nruizneiman/IRis/docs/firmware/dependencies.md

# Dependencies

## Versions the project is built with

| Item | Version | Where | Evidence |
|---|---|---|---|
| PlatformIO Core | 6.2.0 | `.venv` | `pio --version` |
| Platform `espressif32` | 6.12.0 (pinned) | `platformio.ini` | firmware built |
| Arduino-ESP32 core | 2.0.17 | installed `framework-arduinoespressif32` reports `3.20017.241212` | package.json (PlatformIO encodes 2.0.17 as 3.20017.x) |
| Xtensa GCC | 8.4.0 (2021r2-patch5) | PlatformIO package | package.json |
| ArduinoJson | 7.4.2 (pinned in `lib_deps` and vendored for the host build) | firmware + `third_party/` | firmware built; host tests pass |
| U8g2 | 2.36.18 (pinned in `lib_deps`) | firmware | all firmware environments build. In use on an SSD1306 panel; the SH1106 class compiles but was never tried on such a panel |
| IRremoteESP8266 | 2.9.0 (pinned in `lib_deps`) | firmware + PC cross-check | API read from the installed sources; all environments build; the PC cross-check passes ([IR layer](ir.md)). In use on the device, where only NEC remotes were confirmed |
| LittleFS | part of Arduino-ESP32 2.0.17 | firmware | in use on the device; its behaviour under a power cut was not provoked there |
| doctest | 2.4.11 (vendored) | `third_party/doctest` | host tests pass |
| Host compiler | GCC 16.2.0 (WinLibs MinGW-w64 UCRT) | winget | `g++ --version` |

## Not verified

| Item | State |
|---|---|
| IRremoteESP8266 with core 3.x | Unknown; the project stays on core 2.0.17 |
| U8g2 font `u8g2_font_5x8_tf` | The menus read well on the panel; that it renders every Spanish glyph used (n-tilde, accents, inverted ! ?) was not checked one by one |
| Wokwi | Its documentation lists the SSD1306 and a 38 kHz IR receiver, and no SH1106. The project in `wokwi/` was never opened |
| Library sources on the PC | `test/hostlib` reads them from `.pio/libdeps/esp32dev/IRremoteESP8266` (created by `pio run`); not vendored because of the LGPL licence and size |

## Flipper-IRDB (data, not linked code)

- Source: https://github.com/Lucaslhm/Flipper-IRDB. Licence: **CC0 1.0 Universal** (LICENSE file and README read 2026-11-01).
  The README download links point at a different owner (logickworkshop/Flipper-IRDB); whether that is a move or a fork reference is unconfirmed.
- Used as: `.ir` text files copied to the SD card and converted by `lib/iris_core/src/import/FlipperIr.*`. Nothing from the
  repository is bundled in the firmware. One real file is kept as a test fixture (`test/fixtures/irdb_LG.ir`, see `irdb_README.txt`).
- Field meaning for NEC / NECext / Samsung32 / SIRC was confirmed by reading Flipper's encoders (flipperzero-firmware, lib/infrared/encoder_decoder). Other protocols are skipped and counted, not guessed.
