nruizneiman/IRis/case/IRis Mando v2 v24.png

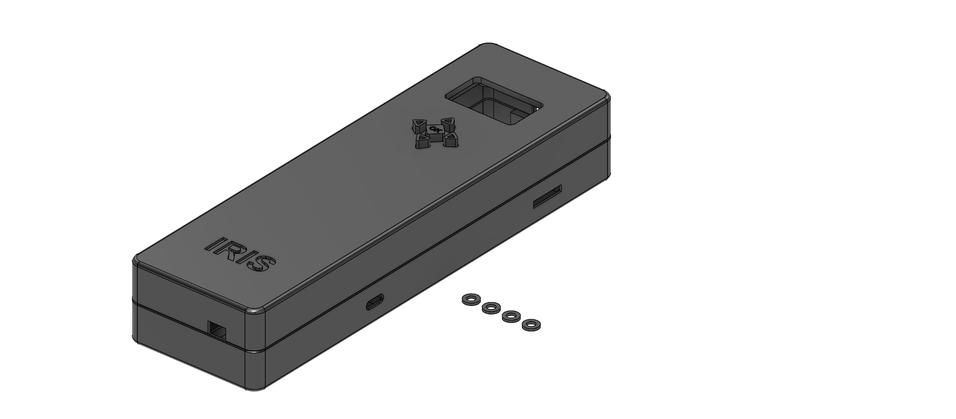
case/IRis Mando v2 v24.png
