nruizneiman/IRis/docs/img/social-preview.png

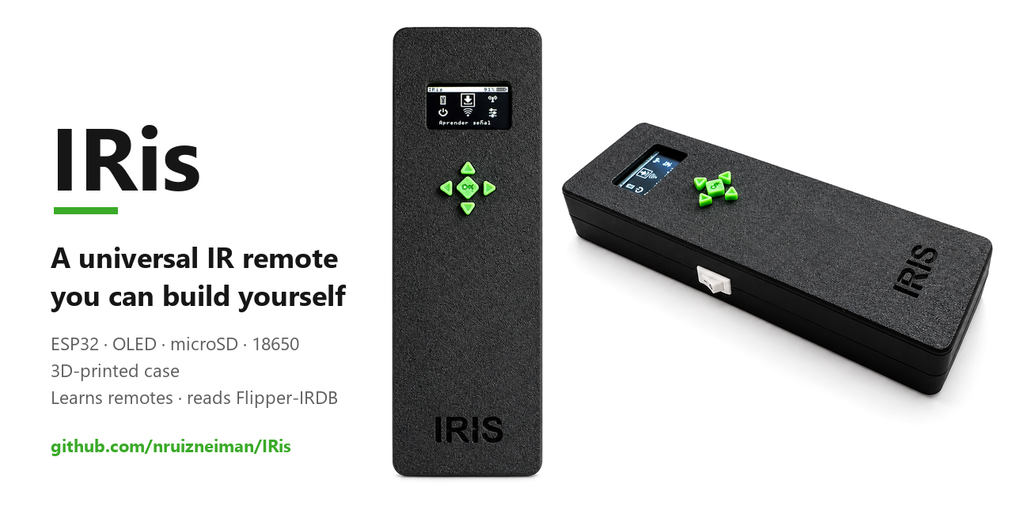
docs/img/social-preview.png
