nruizneiman/IRis/case/IRis Mando v2.step

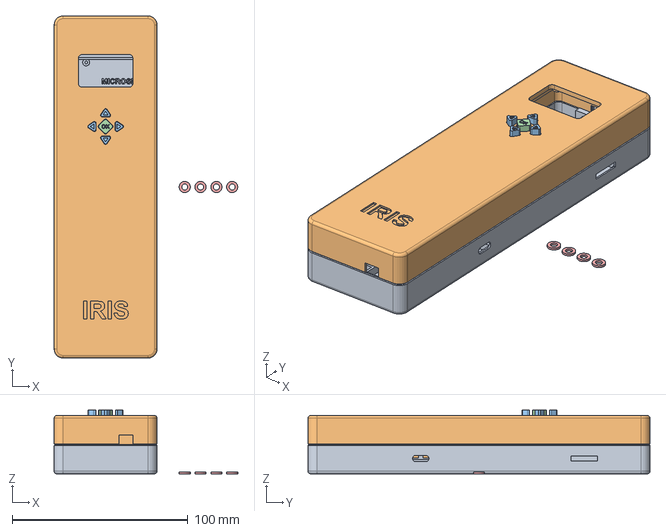
[picture p5: CAD file, 2026-11-11]
case/IRis Mando v2.step
104.5 x 194.5 x 36.2 mm
