nruizneiman/IRis/case/IRIS_Case.3mf

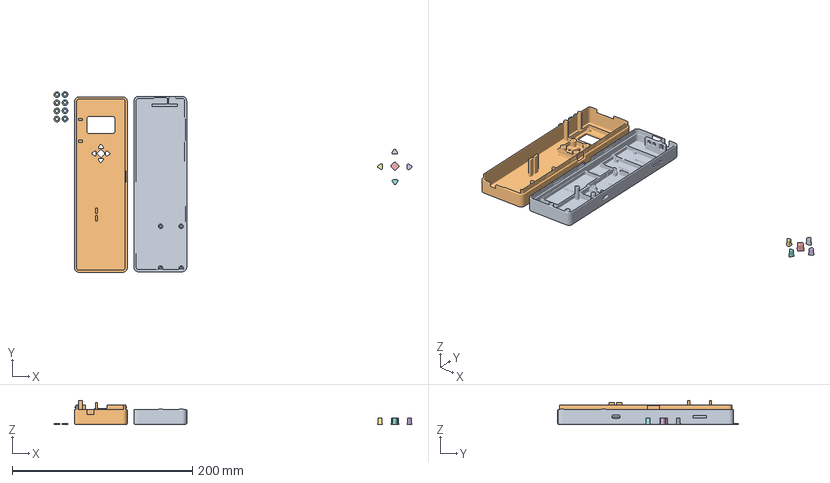
[picture p6: CAD file, 2026-11-11]
case/IRIS_Case.3mf
396.8 x 200.3 x 26.7 mm
base.stl
tapa.stl
arandelas_oled_x4.stl x 2
tecla_ok.stl
tecla_derecha.stl
tecla_izquierda.stl
tecla_abajo.stl
tecla_arriba.stl
