nruizneiman/IRis/(list of files, cad)

Other CAD files:
case/IRis Mando v2.f3d
