nruizneiman/IRis/docs/schematic/IRis.kicad_sch

## KiCad design docs/schematic/IRis.kicad_sch (2026-11-11)

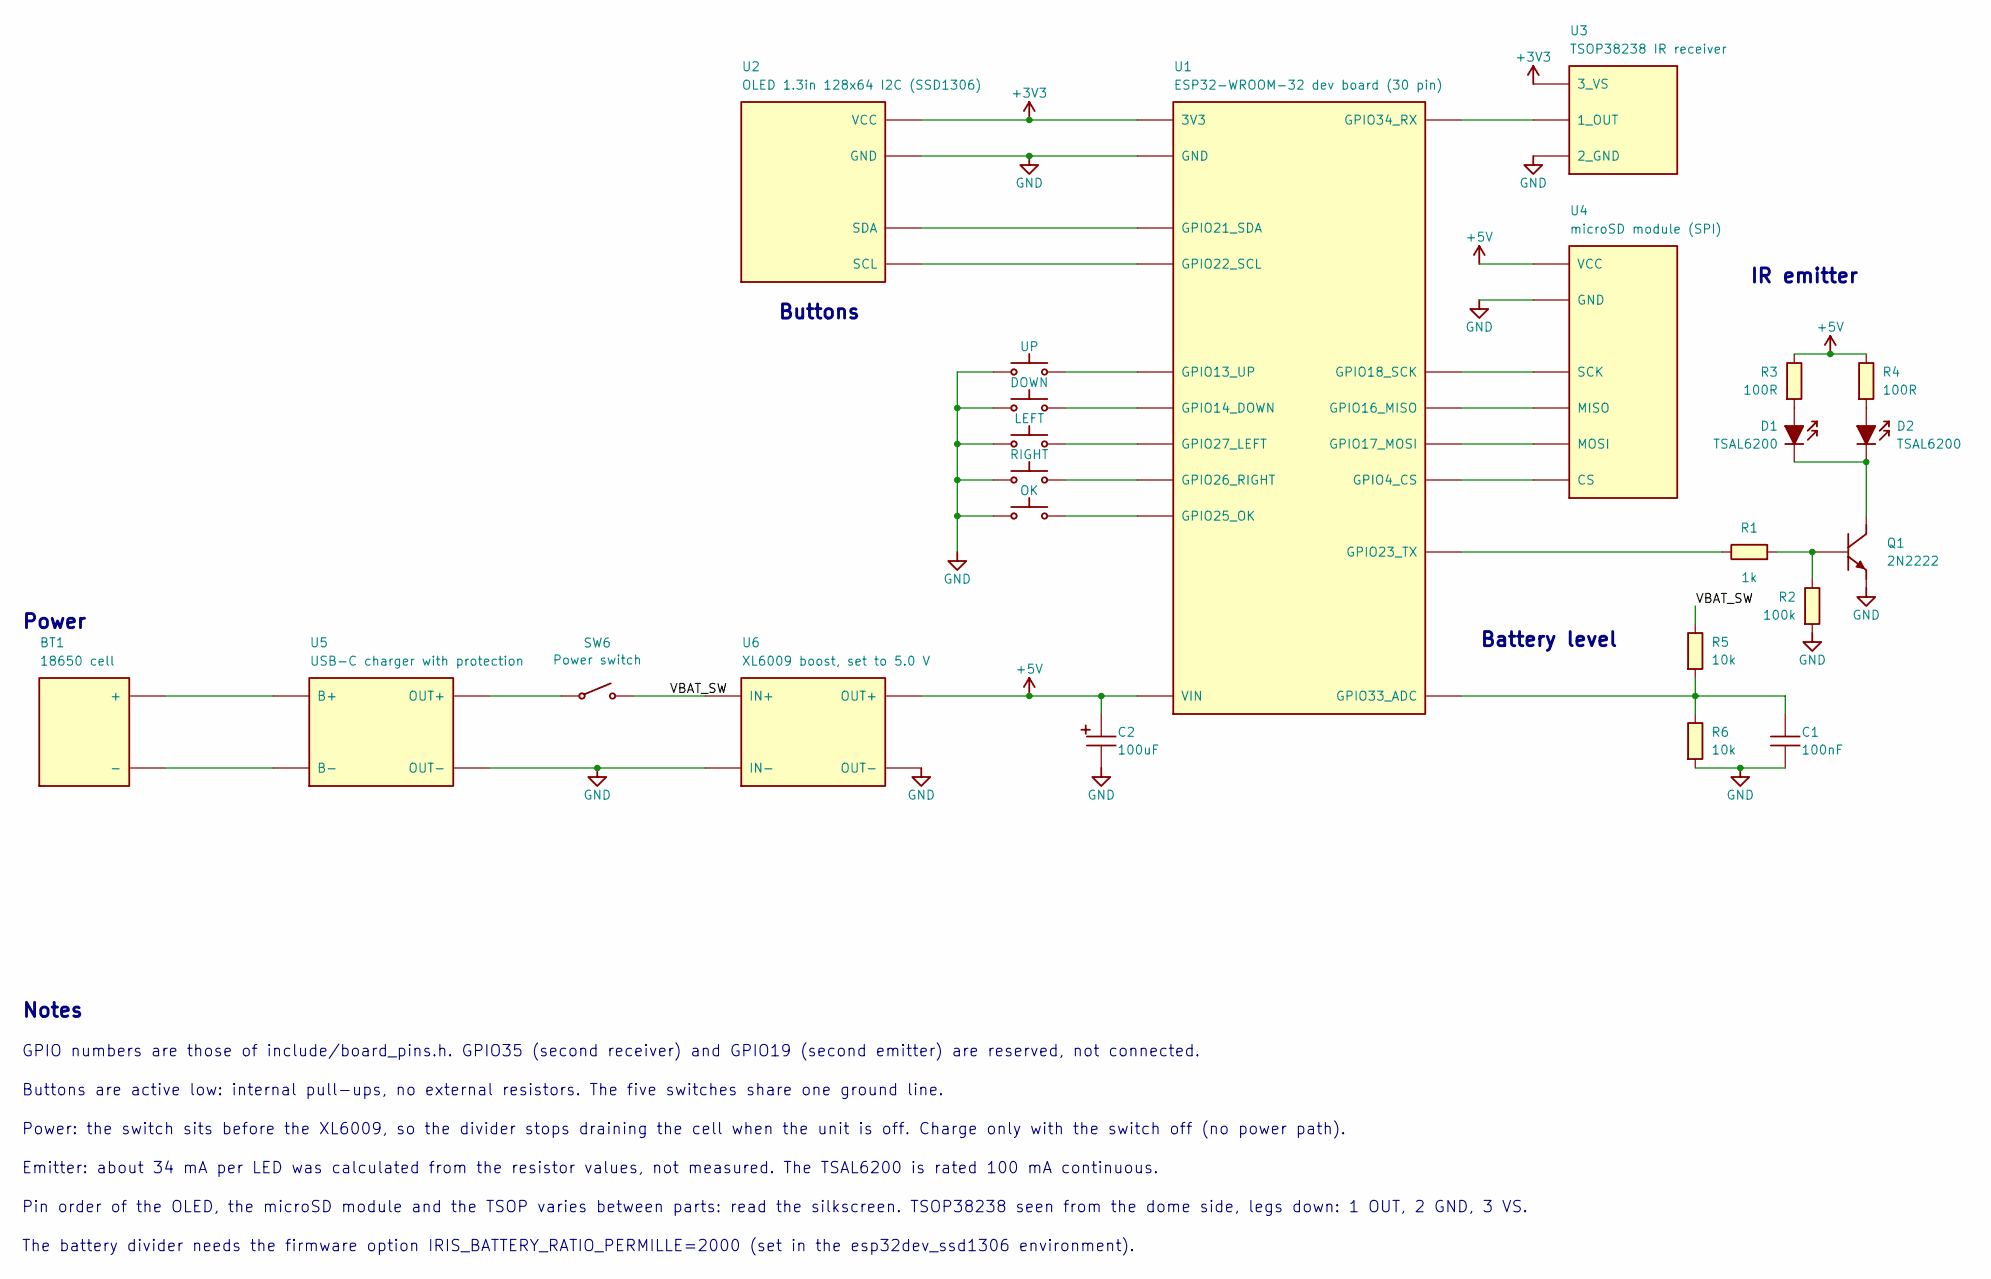
[picture p8: schematic IRis.kicad_sch]

Parts:
BT1: 18650 cell
C1: 100nF
C2: 100uF
D1, D2: TSAL6200
Q1: 2N2222
R1: 1k
R2: 100k
R3, R4: 100R
R5, R6: 10k
SW1: UP
SW2: DOWN
SW3: LEFT
SW4: RIGHT
SW5: OK
SW6: Power switch
U1: ESP32-WROOM-32 dev board (30 pin)
U2: OLED 1.3in 128x64 I2C (SSD1306)
U3: TSOP38238 IR receiver
U4: microSD module (SPI)
U5: USB-C charger with protection
U6: XL6009 boost, set to 5.0 V

Connections:
+3V3: U1.1 (3V3), U2.1 (VCC), U3.1 (3_VS)
+5V: C2.1 (+), R3.1, R4.1, U1.10 (VIN), U4.1 (VCC), U6.3 (OUT+)
GND: C1.2, C2.2 (-), Q1.3 (E), R2.2, R6.2, SW1.1, SW2.1, SW3.1, SW4.1, SW5.1, U1.2 (GND), U2.2 (GND), U3.3 (2_GND), U4.2 (GND), U5.4 (OUT-), U6.2 (IN-), U6.4 (OUT-)
unnamed: BT1.1 (+), U5.1 (B+)
unnamed: BT1.2 (-), U5.2 (B-)
unnamed: C1.1, R5.2, R6.1, U1.17 (GPIO33_ADC)
unnamed: D1.1 (A), R3.2
unnamed: D1.2 (K), D2.2 (K), Q1.2 (C)
unnamed: D2.1 (A), R4.2
unnamed: Q1.1 (B), R1.2, R2.1
unnamed: R1.1, U1.16 (GPIO23_TX)
unnamed: SW1.2, U1.5 (GPIO13_UP)
unnamed: SW2.2, U1.6 (GPIO14_DOWN)
unnamed: SW3.2, U1.7 (GPIO27_LEFT)
unnamed: SW4.2, U1.8 (GPIO26_RIGHT)
unnamed: SW5.2, U1.9 (GPIO25_OK)
unnamed: SW6.1, U5.3 (OUT+)
unnamed: U1.3 (GPIO21_SDA), U2.3 (SDA)
unnamed: U1.4 (GPIO22_SCL), U2.4 (SCL)
unnamed: U1.11 (GPIO34_RX), U3.2 (1_OUT)
unnamed: U1.12 (GPIO18_SCK), U4.3 (SCK)
unnamed: U1.13 (GPIO16_MISO), U4.4 (MISO)
unnamed: U1.14 (GPIO17_MOSI), U4.5 (MOSI)
unnamed: U1.15 (GPIO4_CS), U4.6 (CS)
VBAT_SW: R5.1, SW6.2, U6.1 (IN+)

Notes on the sheet:
Buttons
IR emitter
Battery level
Power
Notes
GPIO numbers are those of include/board_pins.h. GPIO35 (second receiver) and GPIO19 (second emitter) are reserved, not connected.
Buttons are active low: internal pull-ups, no external resistors. The five switches share one ground line.
Power: the switch sits before the XL6009, so the divider stops draining the cell when the unit is off. Charge only with the switch off (no power path).
Emitter: about 34 mA per LED was calculated from the resistor values, not measured. The TSAL6200 is rated 100 mA continuous.
Pin order of the OLED, the microSD module and the TSOP varies between parts: read the silkscreen. TSOP38238 seen from the dome side, legs down: 1 OUT, 2 GND, 3 VS.
The battery divider needs the firmware option IRIS_BATTERY_RATIO_PERMILLE=2000 (set in the esp32dev_ssd1306 environment).
