nruizneiman/IRis/(commit log)

2026-11-01 Initial import of the IRis universal IR remote firmware
    ESP32 firmware (PlatformIO) with a hardware-independent core (domain, app,
    persistence, UI), PC unit/integration/cross-check tests, a console simulator,
    bench and display-probe firmwares, wiring guide, physical test plan and the
    bench test logs recorded so far (B2-B8 and the microSD module).
    Bench findings recorded in docs/logs: the emitter driver (IRFZ44N from a 3.3 V
    GPIO) did not switch on, so the LED is currently driven straight from the GPIO
    through 220 ohm as a temporary measure. The Flipper-IRDB import is only partly
    done: the parser is tested on the PC and files can be copied to the SD card over
    serial, but there is no on-devic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
    [ArduinoClock.h, GpioButtons.h, IrReceiverAdapter.h, IrTransmitterAdapter.h, PersistentStore.h, Simulator.cpp, Simulator.h, UnavailableIr.h]
2026-11-01 Icon-grid home screen, on-screen keyboard and suggested names
    Display contract: bitmap drawing and a draw colour (dark text on lit bars). The
    title bar and the selected row are drawn as lit bars, long lists get a scroll
    bar. Home becomes a 3x2 grid of 16x16 icons (original drawings). Text entry is an
    on-screen keyboard with three pages and one-shot shift; new button, category and
    control names offer a list of typical names first. FakeDisplay can now write a
    picture (PBM) of what it shows; tools/pbm_to_png.py converts it.
    Tests adapted to the new navigation (162 unit/integration, all passing) and new
    keyboard tests. Firmware environments all build. Not yet seen on the real panel.
    Also: tool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
2026-11-01 Import Flipper-IRDB files from the SD card, optional battery monitor
    New home icon "Importar": browse /irdb on the card, preview a .ir file (buttons found,
    unsupported / invalid counts) and create a control from it, with unique names and an
    all-or-nothing RemoteLibrary::importRemote. IFileSource + FakeFileSource, SdFileSource
    for the ESP32 (read only, lazy mount, throttled retry). 168 unit/integration tests pass;
    firmware builds for all environments. Not yet loaded on the board (BOOT could not be held).
    AdcBatteryMonitor on GPIO33 behind -DIRIS_BATTERY_RATIO_PERMILLE (off by default, so a
    floating pin never shows noise). Docs: divider notes and the temporary GPIO-drive exception.
    Co-Author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
    [AdcBatteryMonitor.h, SdFileSource.h, main.cpp, test_import.cpp, test_ui_flows.cpp, ui_helpers.h]
2026-11-03 Document battery power bring-up, NPN emitter driver and assembly plan
2026-11-03 Enable the battery voltage reading in the SSD1306 build and log the first comparison
2026-11-03 Show an estimated battery level with bars in the home title bar
    The exact voltage moves to the diagnostics page. The estimate comes from a generic
    Li-ion curve and is marked with a tilde.
2026-11-03 Smooth the battery estimate and drop the tilde from the title bar
2026-11-10 Add loop, crazy, Be Gone and listening modes, SD controls beside saved ones, folder import and export
    Saved and card controls share one view (RemoteView), the modes run on a common sequence
    runner, the home screen is a two-page icon grid, the button cap is raised (256 saved, 512 from
    the card) and the battery estimate reaches 100 % for a full cell measured under load.
2026-11-11 Compensate the voltage lost between the cell and the battery divider
    Measured 0.11 V (cell 4.09 V, divider 3.98 V with the device running); the level estimate adds it.
2026-11-11 Take 4.10 V of estimated cell voltage as 100 %
2026-11-11 Prepare the repository for publication: new README, GPL-3.0 licence, current status
    The README and the status page described a project that had never run on hardware; the unit is now assembled and
    working. The bench logs are removed and their results summarised in docs/hardware.md. Stale banners in the wiring guide,
    the risks list, the test plan and the pin map are corrected (the emitter driver is an NPN transistor, not a MOSFET).
    [IRIS_Case.3mf]
2026-11-11 Link the printable case on MakerWorld
2026-11-11 Add a bill of materials
2026-11-11 Add the photo to the README and record the IR LED model
2026-11-11 Add the connection diagram as a KiCad schematic
    [IRis.kicad_sch]
2026-11-11 Add the Fusion, STEP and preview files of the case
    [IRis Mando v2.f3d, IRis Mando v2.step]
2026-11-11 Reorganise the documentation by subject and bring it up to date
    Documents move into docs/hardware and docs/firmware, with an index in
    docs/README.md. The wiring guide now describes the circuit as built; the
    pre-build reasoning is kept as design notes. The draft assembly plan is
    removed. The case document quotes the dimensions of the current model,
    and menu names in the guides are the English ones.
2026-11-11 Translate the boot notices, drop stage references, version 0.6.1
    The storage notices shown at boot now have English text, and the two that
    did not fit the 21 columns of the footer are shorter.
    [Simulator.h, UnavailableIr.h, VolatileBlobStore.h, main.cpp, test_language.cpp, test_ui_flows2.cpp]
2026-11-12 Import every Flipper protocol and add a converter for other sources
    The importer no longer drops signals: RC5 and RC5X become decoded frames,
    and RC6, Kaseikyo, RCA, Pioneer, NEC42 and NECext without an inverse
    command byte are kept as the raw frame Flipper would send. The exporter
    writes RC5 as RC5 and JVC as raw.
    tools/ir_convert.py turns LIRC and Pronto codes into Flipper .ir files and
    leaves out remotes that Flipper-IRDB already has. irdb-extra/ is the place
    for the remotes it lacks.
    [ir_convert.py, test_export.cpp, test_import.cpp, test_ir_convert.py]
